barkadosh1/Parky/parky.SLDASM

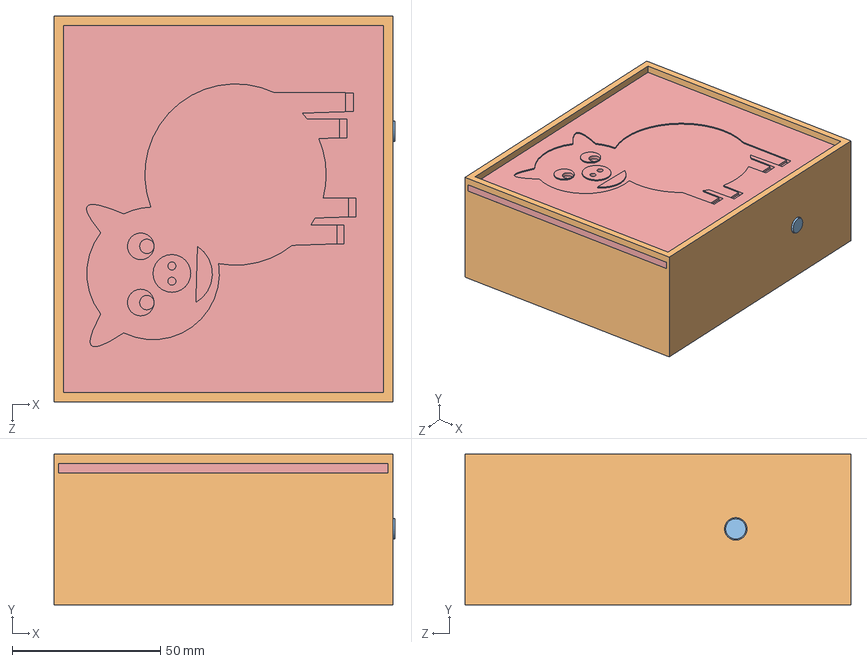
[picture p18: CAD file, 2020-01-05]
parky.SLDASM
115.0 x 50.8 x 130.2 mm
battery
case
raspi camera
raspi
lid
