barkadosh1/Parky/raspi camera.SLDPRT

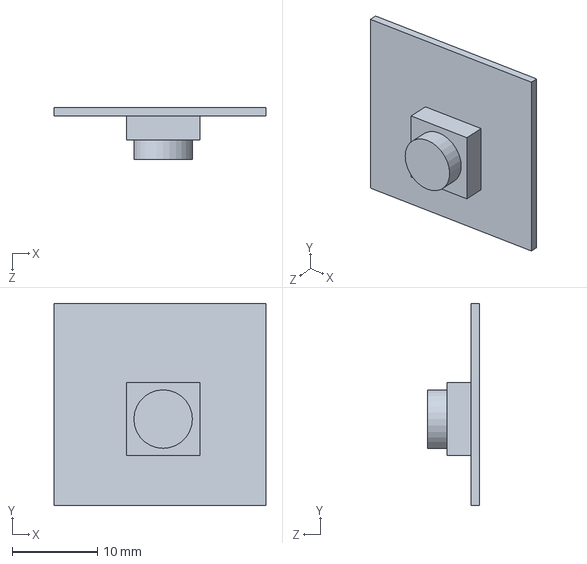
[picture p19: CAD file, 2020-01-05]
raspi camera.SLDPRT
24.8 x 23.7 x 6.13 mm
