barkadosh1/Parky/raspi.SLDPRT

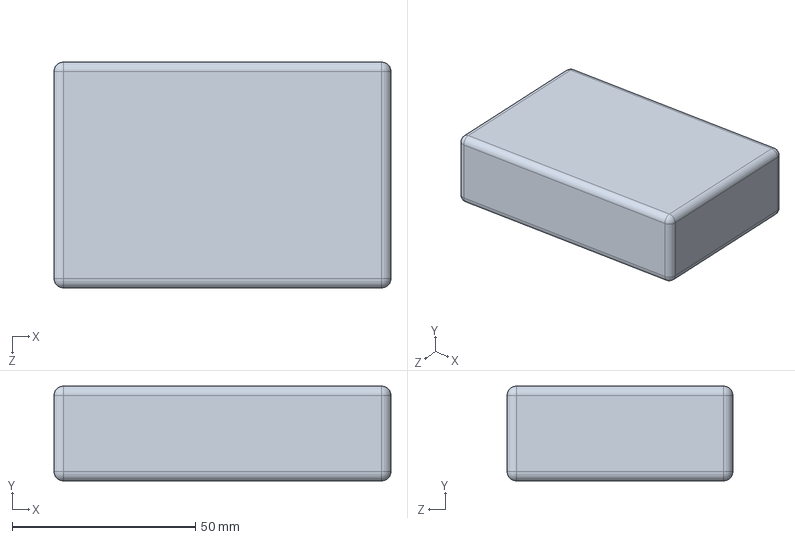
[picture p20: CAD file, 2020-01-05]
raspi.SLDPRT
92.0 x 25.9 x 61.7 mm
