barkadosh1/Parky/battery.SLDPRT

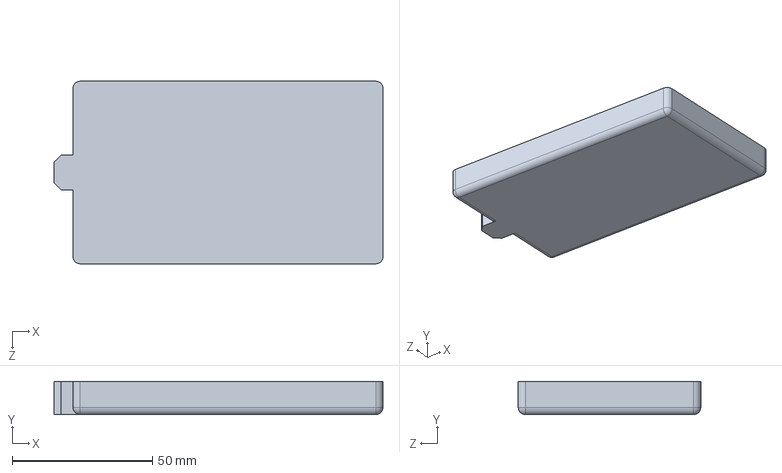
[picture p21: CAD file, 2020-01-05]
battery.SLDPRT
117.5 x 11.8 x 65.2 mm
