barkadosh1/Parky/case.SLDPRT

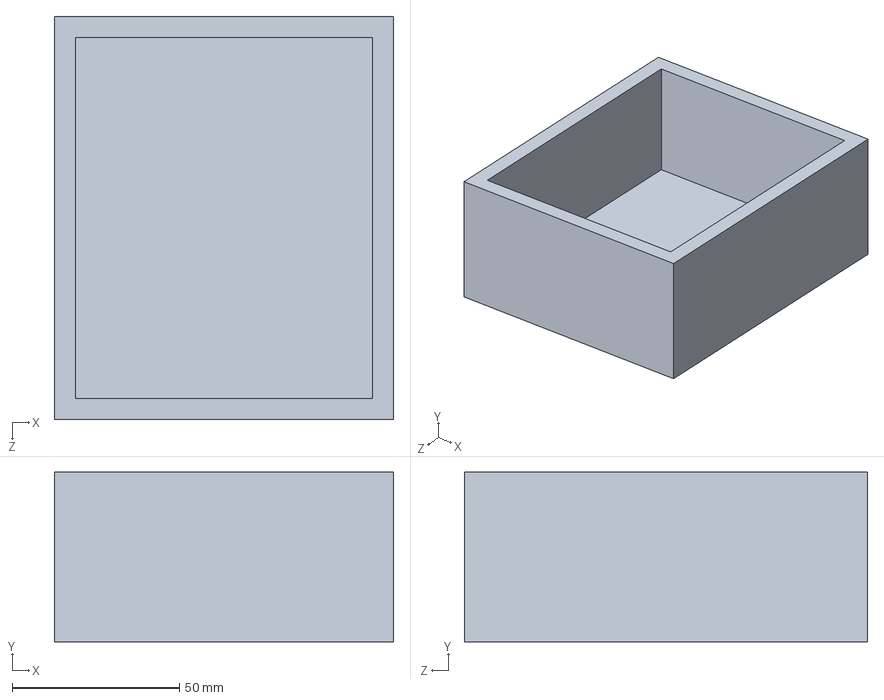
[picture p22: CAD file, 2020-01-05]
case.SLDPRT
101.6 x 50.8 x 120.7 mm
