barkadosh1/Parky/lid.SLDPRT

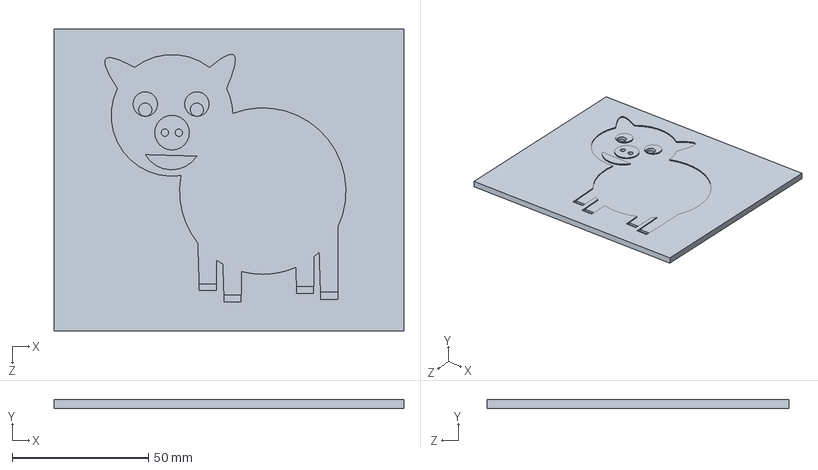
[picture p23: CAD file, 2020-01-05]
lid.SLDPRT
128.6 x 3.17 x 111.1 mm
